ntut-rf/cc1200/cc.kicad_pcb

## KiCad design cc.kicad_pcb (2017-03-21)

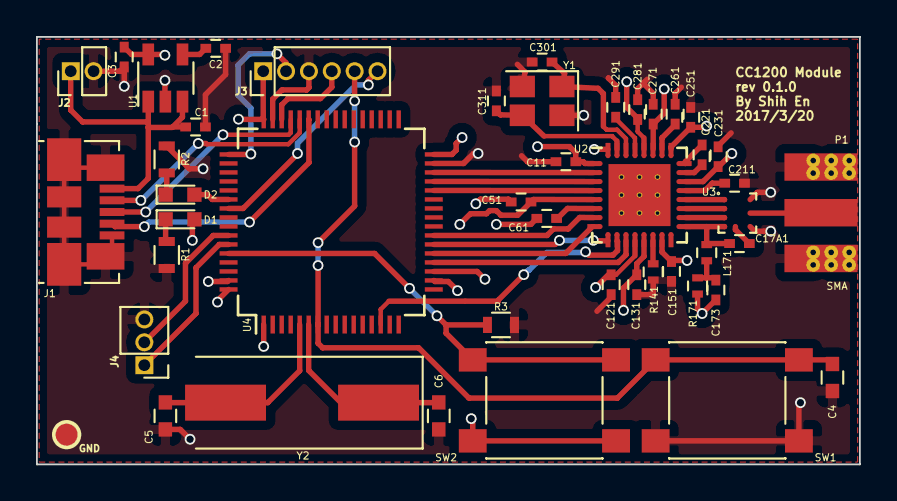
[picture p1: board cc.kicad_pcb from above]

Board: 4 copper layers, 45.7 x 23.7 mm, 46 parts (0 on the bottom side), 43 nets.

Parts:
C1: 0.1uF; C_0402
C2: 0.01uF; C_0402
C3: 2.2uF; C_0402
C4: 0.1uF/25V; C_0603
C5, C6: 20pF; C_0603
C11, C51, C121, C131, C151, C221, C251, C261, C271, C281, C291: 47nF; C_0402
C17A1: 100pF; C_0402
C61: 220nF; C_0402
C173: 56pF; C_0402
C211: 10nF; C_0402
C231: 1.5nF; C_0402
C301, C311: 15pF; C_0402
D1: LED_PWR; LED_0603
D2: LED_TEST; LED_0603
GND: GND; TESTPOINT-50MIL
J1: USB_OTG; USB_Micro-B_Molex_47346-0001
J2: CONN_PWR; Pin_Header_Straight_1x02_Pitch1.27mm
J3: CONN_DEBUG; Pin_Header_Straight_1x06_Pitch1.27mm
J4: CONN_USART; Pin_Header_Straight_1x03_Pitch1.27mm
L171: 56nH; L_0402
P1: SMA; SMA-EDGE
R1, R2: 200; R_0603
R3: 10k; R_0603
R141: 56k; R_0402
R171: 18; R_0402
SW1, SW2: SW_Push; SW_SPST_PTS645
U1: TPS79333; TSOT-23-5
U2: CC1200
U3: BALF-112X-02D3
U4: STM32L475RC; LQFP-64_10x10mm_Pitch0.5mm
Y1: 40MHz; NX3225SA-40M-EXS00A-CS03880
Y2: 8MHz(16pF); Crystal_SMD_HC49-SD

Connections:
+5V: C1.1, J1.1, J2.1, U1.1, U1.3
CC_GPIO0: U2.10, U4.14
CC_GPIO2: U2.4, U4.28
CC_GPIO3: U2.3, U4.29
CC_MISO: U2.9, U4.22
CC_MOSI: U2.7, U4.23
CC_NSS: U2.11, U4.20
CC_RESET_N: U2.2, U4.30
CC_SCLK: U2.8, U4.21
GND: C1.2, C2.2, C3.2, C4.1, C5.2, C6.2, C11.2, C51.2, C61.2, C121.2, C131.2, C151.2, C211.2, C221.2, C251.2, C261.2, C271.2, C281.2, C291.2, C301.2, C311.2, J1.5, J1.6, J2.2, J3.3, J4.3, P1.2, R1.2, R2.1, R3.2, R141.2, SW1.2, U1.2, U2.32, U2.33, U3.A1, U3.E1, U4.18, U4.31, U4.47, U4.63, Y1.2, Y1.4
NRST: C4.2, J3.5, SW1.1, U4.7
unnamed: C2.1, U1.4
unnamed: C5.1, U4.5, Y2.2
unnamed: C6.1, U4.6, Y2.1
unnamed: C17A1.1, L171.1, U2.17, U3.E3
unnamed: C17A1.2, U3.E2
unnamed: C61.1, U2.6
unnamed: C173.1, L171.2, R171.1
unnamed: C211.1, U2.21
unnamed: C231.1, U2.24
unnamed: C231.2, U2.23
unnamed: C261.1, U2.26
unnamed: C291.1, U2.29
unnamed: C301.1, U2.30, Y1.1
unnamed: C311.1, U2.31, Y1.3
unnamed: D1.1, R1.1
unnamed: D2.1, R2.2
unnamed: D2.2, U4.54
unnamed: P1.1, U3.C1
unnamed: R3.1, SW2.2, U4.60
unnamed: R141.1, U2.14
unnamed: U2.18, U3.D3
unnamed: U2.19, U3.B3
unnamed: U2.20, U3.A3
SWCLK: J3.2, U4.49
SWDIO: J3.4, U4.46
SWO: J3.6, U4.55
USART_RX: J4.1, U4.59
USART_TX: J4.2, U4.58
USB_DM: J1.2, U4.44
USB_DP: J1.3, U4.45
USB_ID: J1.4, U4.43
VDD: C3.1, C11.1, C51.1, C121.1, C131.1, C151.1, C173.2, C221.1, C251.1, C271.1, C281.1, D1.2, J3.1, R171.2, SW2.1, U1.5, U2.1, U2.5, U2.12, U2.13, U2.15, U2.22, U2.25, U2.27, U2.28, U4.1, U4.19, U4.32, U4.48, U4.64
