ntut-rf/cc1200/RFM.kicad_pcb

## KiCad design RFM.kicad_pcb (2017-03-17)

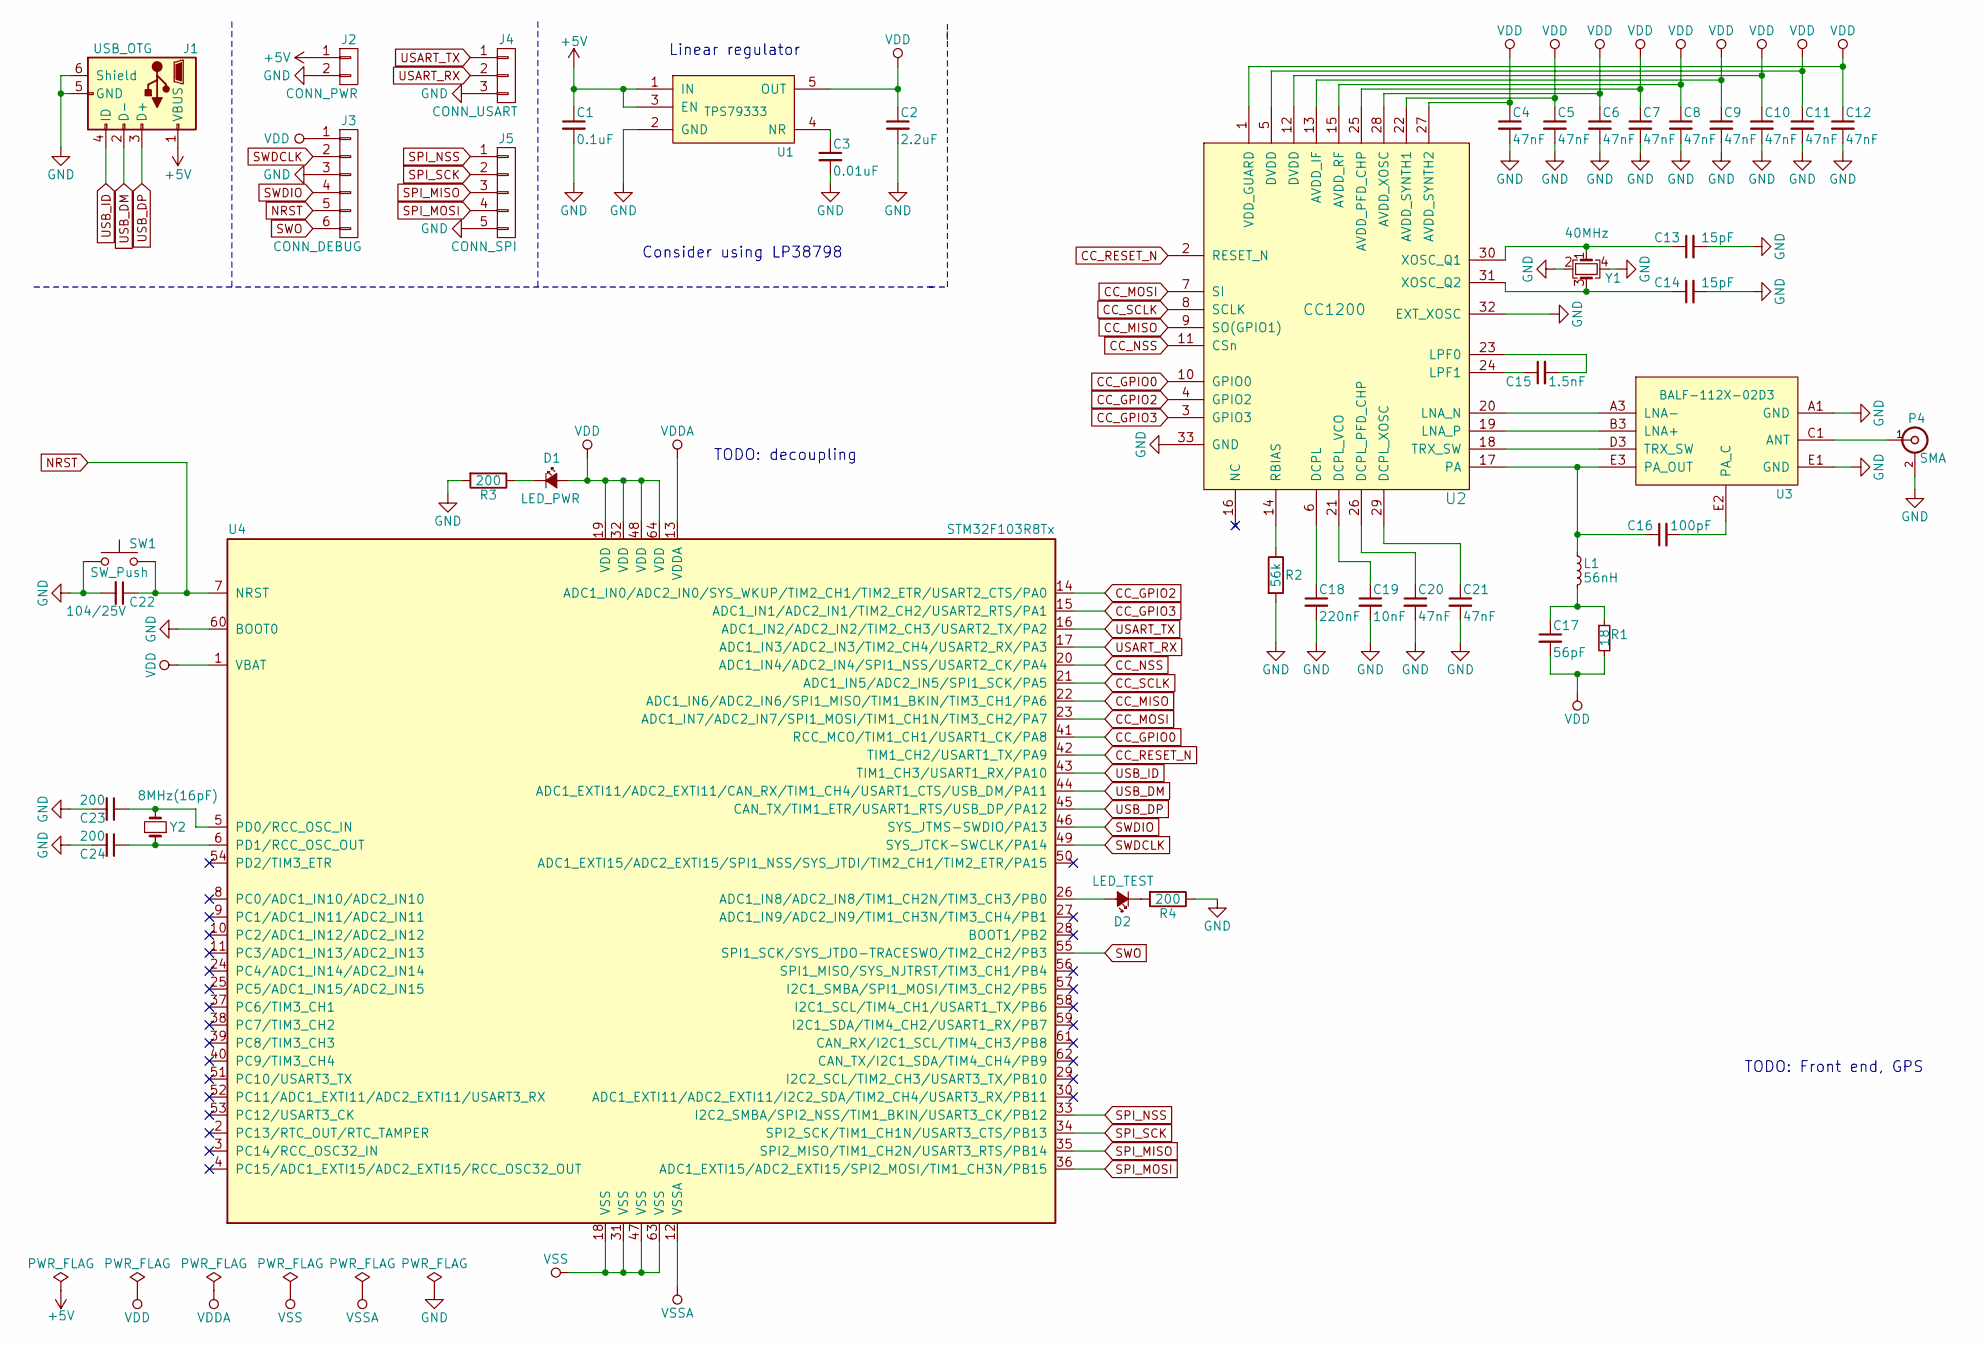
[picture p2: schematic RFM.sch]

Parts:
C1: 0.1uF; C_0402
C2: 2.2uF; C_0402
C3: 0.01uF; C_0402
C4, C5, C6, C7, C8, C9, C10, C11, C12, C20, C21: 47nF; C_0402
C13, C14: 15pF; C_0402
C15: 1.5nF; C_0402
C16: 100pF; C_0402
C17: 56pF; C_0402
C18: 220nF; C_0402
C19: 10nF; C_0402
C22: 104/25V; C_0603
C23, C24: 200; C_0603
D1: LED_PWR; LED_0603
D2: LED_TEST; LED_0603
J1: USB_OTG; USB_Micro-B_Molex_47346-0001
J2: CONN_PWR; Pin_Header_Angled_1x02_Pitch2.54mm
J3: CONN_DEBUG; Pin_Header_Angled_1x06_Pitch2.54mm
J4: CONN_USART; Pin_Header_Angled_1x03_Pitch2.54mm
J5: CONN_SPI; Pin_Header_Angled_1x05_Pitch2.54mm
L1: 56nH; L_0402
P4: SMA; SMA-EDGE
R1: 18; R_0402
R2: 56k; R_0402
R3, R4: 200; R_0603
SW1: SW_Push; SW_SPST_PTS645
U1: TPS79333; TSOT-23-5
U2: CC1200
U3: BALF-112X-02D3
U4: STM32F103R8Tx; LQFP-64_10x10mm_Pitch0.5mm
Y1: 40MHz; NX3225SA-40M-EXS00A-CS03880
Y2: 8MHz(16pF)

Connections:
+5V: C1.1, J1.1 (VBUS), J2.1, U1.1 (IN), U1.3 (EN)
CC_GPIO0: U2.10 (GPIO0), U4.41 (RCC_MCO/TIM1_CH1/USART1_CK/PA8)
CC_GPIO2: U2.4 (GPIO2), U4.14 (ADC1_IN0/ADC2_IN0/SYS_WKUP/TIM2_CH1/TIM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)
CC_GPIO3: U2.3 (GPIO3), U4.15 (ADC1_IN1/ADC2_IN1/TIM2_CH2/USART2_RTS/P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)
CC_MISO: U2.9 (SO(GPIO1)), U4.22 (ADC1_IN6/ADC2_IN6/SPI1_MISO/TIM1_BKIN/T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)
CC_MOSI: U2.7 (SI), U4.23 (ADC1_IN7/ADC2_IN7/SPI1_MOSI/TIM1_CH1N/T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)
CC_NSS: U2.11 (CSn), U4.20 (ADC1_IN4/ADC2_IN4/SPI1_NSS/USART2_CK/PA4)
CC_RESET_N: U2.2 (RESET_N), U4.42 (TIM1_CH2/USART1_TX/PA9)
CC_SCLK: U2.8 (SCLK), U4.21 (ADC1_IN5/ADC2_IN5/SPI1_SCK/PA5)
GND: C1.2, C2.2, C3.2, C4.2, C5.2, C6.2, C7.2, C8.2, C9.2, C10.2, C11.2, C12.2, C13.2, C14.2, C18.2, C19.2, C20.2, C21.2, C22.2, C23.2, C24.2, J1.5 (GND), J1.6 (Shield), J2.2, J3.3, J4.3, J5.5, P4.2 (Ext), R2.2, R3.2, R4.1, SW1.1, U1.2 (GND), U2.32 (EXT_XOSC), U2.33 (GND), U3.A1 (GND), U3.E1 (GND), U4.60 (BOOT0), Y1.2, Y1.4
NRST: C22.1, J3.5, SW1.2, U4.7 (NRST)
unnamed: C3.1, U1.4 (NR)
unnamed: C13.1, U2.30 (XOSC_Q1), Y1.1
unnamed: C14.1, U2.31 (XOSC_Q2), Y1.3
unnamed: C15.1, U2.24 (LPF1)
unnamed: C15.2, U2.23 (LPF0)
unnamed: C16.1, L1.1, U2.17 (PA), U3.E3 (PA_OUT)
unnamed: C16.2, U3.E2 (PA_C)
unnamed: C17.1, L1.2, R1.1
unnamed: C18.1, U2.6 (DCPL)
unnamed: C19.1, U2.21 (DCPL_VCO)
unnamed: C20.1, U2.26 (DCPL_PFD_CHP)
unnamed: C21.1, U2.29 (DCPL_XOSC)
unnamed: C23.1, U4.5 (PD0/RCC_OSC_IN), Y2.2
unnamed: C24.1, U4.6 (PD1/RCC_OSC_OUT), Y2.1
unnamed: D1.1 (K), R3.1
unnamed: D2.1 (K), R4.2
unnamed: D2.2 (A), U4.26 (ADC1_IN8/ADC2_IN8/TIM1_CH2N/TIM3_CH3/PB0)
unnamed: P4.1 (In), U3.C1 (ANT)
unnamed: R2.1, U2.14 (RBIAS)
unnamed: U2.18 (TRX_SW), U3.D3 (TRX_SW)
unnamed: U2.19 (LNA_P), U3.B3 (LNA+)
unnamed: U2.20 (LNA_N), U3.A3 (LNA-)
SPI_MISO: J5.3, U4.35 (SPI2_MISO/TIM1_CH2N/USART3_RTS/PB14)
SPI_MOSI: J5.4, U4.36 (ADC1_EXTI15/ADC2_EXTI15/SPI2_MOSI/TIM1_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)
SPI_NSS: J5.1, U4.33 (I2C2_SMBA/SPI2_NSS/TIM1_BKIN/USART3_CK/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)
SPI_SCK: J5.2, U4.34 (SPI2_SCK/TIM1_CH1N/USART3_CTS/PB13)
SWDCLK: J3.2, U4.49 (SYS_JTCK-SWCLK/PA14)
SWDIO: J3.4, U4.46 (SYS_JTMS-SWDIO/PA13)
SWO: J3.6, U4.55 (SPI1_SCK/SYS_JTDO-TRACESWO/TIM2_CH2/PB3)
USART_RX: J4.2, U4.17 (ADC1_IN3/ADC2_IN3/TIM2_CH4/USART2_RX/PA3)
USART_TX: J4.1, U4.16 (ADC1_IN2/ADC2_IN2/TIM2_CH3/USART2_TX/PA2)
USB_DM: J1.2 (D-), U4.44 (ADC1_EXTI11/ADC2_EXTI11/CAN_RX/TIM1_CH4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)
USB_DP: J1.3 (D+), U4.45 (CAN_TX/TIM1_ETR/USART1_RTS/USB_DP/PA12)
USB_ID: J1.4 (ID), U4.43 (TIM1_CH3/USART1_RX/PA10)
VDD: C2.1, C4.1, C5.1, C6.1, C7.1, C8.1, C9.1, C10.1, C11.1, C12.1, C17.2, D1.2 (A), J3.1, R1.2, U1.5 (OUT), U2.1 (VDD_GUARD), U2.5 (DVDD), U2.12 (DVDD), U2.13 (AVDD_IF), U2.15 (AVDD_RF), U2.22 (AVDD_SYNTH1), U2.25 (AVDD_PFD_CHP), U2.27 (AVDD_SYNTH2), U2.28 (AVDD_XOSC), U4.1 (VBAT), U4.19 (VDD), U4.32 (VDD), U4.48 (VDD), U4.64 (VDD)
VSS: U4.18 (VSS), U4.31 (VSS), U4.47 (VSS), U4.63 (VSS)

Notes on the sheet:
Linear regulator
TODO: Front end, GPS
Consider using LP38798
TODO: decoupling

Board: 2 copper layers, 44 parts (0 on the bottom side), 47 nets, no tracks yet.
