ntut-rf/cc1200/(commit log)

2017-03-15 Start drawing CC1200 footprint
2017-03-15 Update footprint assignments
    [RFM.sch]
2017-03-16 CC1200 footprint
    [RFM.sch]
2017-03-16 Balun footprint
    [RFM.kicad_pcb, RFM.sch]
2017-03-17 Update footprints
    [RFM.kicad_pcb, RFM.sch]
2017-03-18 Use STM32L475RC
    [cc.sch]
2017-03-18 Footprint spreadout
    [cc.kicad_pcb, cc.sch]
2017-03-18 PCB layout WIP
    [cc.kicad_pcb, cc.sch]
2017-03-20 Component layout etc.
    [cc.kicad_pcb, cc.sch]
2017-03-21 Pre v0.1.0
    [cc-B.Cu.gbr, cc-Edge.Cuts.gbr, cc-F.Cu.gbr, cc-F.Mask.gbr, cc-F.Paste.gbr, cc-F.SilkS.gbr, cc-In1.Cu.gbr, cc-In2.Cu.gbr]
